Rizlenee/Droduino/README.md

Ce projet est réalisé dans le cadre de la formation de prépa intégrée de Polytech'Nice Sophia. 

<h1>Projet Arduino PeiP2</h1>

<h2>DRODUINO</h2>

Les membres de la (dream)team pour ce projet sont:
<ul>
<li>EL BOUCHIKHI Rizlène</li>
<li>ERRIADI Yasmin</li>
<li>BAUCE Camille</li>
</ul>

<h2>LE PROJET</h2>
Nous souhaitons construire un drone de vitesse, équipée d'un caméra reliée à casque FPV et de plusieurs améliorations ludiques facilitant le pilotage à savoir une de batterie qui s'allume quand la batterie est faible, des leds de position dont la télcommande peut changer les couleurs, des phares dont l'intensité peut être modifiée par la télécommande également et un buzzer déclenchable à distance par la télécommande en cas de perte du drone.

<h2>DOCUMENTATION :</h2>
<ul>
<li>manuel de la SPRacingF3 (controlleur de vol) : http://seriouslypro.com/files/SPRacingF3-Manual-latest.pdf</li>
<li>identification pin ESC : https://github.com/sim-/tgy/wiki/Identifying-ESC-pin-configuration</li>
 </ul>

<h2>COMPOSANTS PRINCIPAUX :</h2>

  - 1x Chassis
  - 4x Moteurs
  - 4x Controleurs de vitesse électronique (ESC)
  - 4x Helices
  - 1x Batterie
  - 1x Controleur de vol (carte arduino ou non)
  - 1x Lunettes FPV (on a les lunettes fatshark fpv 1100 avec sa camera)
  - 1x Radio Emetteur/Recepteur (aka manette et recepteur de la manette pour la carte)

<h2>PROJET TERMINE</h2>

<p>
 
 
 </p>
