Rizlenee/Droduino/doc/Yasmin ERRIADI.md

<h1>CARNET DE BORD DE YASMIN</h1> 

* <h2>Séance du 22 Décembre 2017:</h2>

Nous avons réflechi à un sujet pour le projet. Après avoir longuement discuté avec les deux autres membres du groupe, nous nous sommes
décidé sur la coonception d'un drône. Puis après concertation avec Mr Masson, nous avons finit par choisir de faire un drône de vitesse
avec des lunettes connectées (drône FPV). J'ai alors entamé, les recherches sur le fonctionnement d'un drône FPV.

* <h2>Séance du 12 Janvier 2018:</h2>

Nous avons continué les recherches sur le fonctionnement d'un drône, j'ai trouvé ce site très intéressant:
http://www.geekmag.fr/quadricoptere-fonctionnement-configuration-et-pilotage-rc/. 
J'ai regardé des vidéos sur des courses avec des FPV, dont celle là https://www.youtube.com/watch?v=hjFoPGniwdk où l'on a la vue
dans sur les lunettes reliées à la camera sur le drone.

* <h2>Séance du 18 Janvier 2018:</h2>

J'ai fait des recherches sur les pièces nécessaires pour l'assemblage du drone (chassis, esc et moteur), afin de preparer notre 
première commande. J'ai cherché sur le site: https://www.drone-fpv-racer.com/, nous avons réparé certaines pièces mais nous hésitions toujours. 
J'ai également commencé à préparer la présentation orale.

* <h2>Séance du 23 Janvier 2018:</h2>

Nous avons fait notre présentation du projet et j'ai ecouté les présentations des autres. Nous avons également posé pour le magazine de la 
CASA avec le drone fait par Julien l'an dernier.

* <h2>Séance du 02 Février 2018:</h2>
Nous avons reçu le colis du kit d'assemblage du drone. Nous avons donc commencé l'assemblage du chassis, nous avons vissé les parties inferieures du chassis ensemble et les parties superieures ensemble. 
Nous n'assemblerons les deux parties du chassis qu'une fois que l'on aura ajouté les autres composants.

* <h2>Après-midi du 15 Février 2018:</h2>
Nous avons vissé les moteurs au chassis puis nous avons mis les hélices que nous n'avons pas laissé par manque de praticité.

* <h2>Journée du 21 Février 2018:</h2>
Il nous fallait des entretoises pour séparer la carte de vol et la carte de distribution d'énergie que camille est allée au fablab:

 
 * <h2>Séance du 16 Mars 2018:</h2>
 Nous avons soudé les esc avec les moteurs, d'abord Mr.Ferreronous a montré puis nous sommes allé au Fablab. Puis nous avons soudé des pins à la carte de vol pour y brancher les ecs ou les led plus tard.
 
  
 * <h2>Après-midi du 28 Mars 2018:</h2> 
 Nous sommes allées au Fablab pour souder les esc à la plaque de distribution d'énergie ainsi que rajouter des pins.
 
 * <h2>Séance du 29 Mars 2018:</h2>
 Nous avons soudé la prise pour brancher la batterie à la plaque de distribution. Le prof nous a donné les lunettes FPV et la caméra. Il faut maintenant connecter les esc à la carte de vol et tester les moteurs.
 
 * <h2>Séance du 5 Avril 2018:</h2>
 Nous avons ressoudé les branchements esc-moteurs les moteurs tournés tous dans le même sens et que l'on arrivait pas acceder aux esc. Nous avons fait des recherches sur la radio et la télécommande, puis onous avons commencé les branchements de la radio.
 
 * <h2>Séance du 9 Avril 2018:</h2>
 Lors des tests effectués par Camille un des esc a brulé, on a donc déssoudé cet esc pendant la séance. Nous avons fait notre présentation, à la fin le prof nous a suggéré d'utiliser une arduino pro-micro pour le branchement des led et du buzzer pour ne pas toucher au programme de la carte de vol.

 * <h2>Séance du 2 Mai 2018:</h2>
   Mr Masson nous a donné les leds strips et nous avons essayé de comprendre leur fonctionnement.

 * <h2>Séance du 9 Mai 2018:</h2>
 Nous avons testé  des codes avec les leds strips connecté à la pro-micro. La carte chauffe nous avons donc essyé avec des leds.

 * <h2>Après-midi du 24 Mai 2018:</h2>
 J'ai cherché comment fonctionne le buzzer que nous avons reçu sachant que ce n'était pas tout à fait celui que nous avions commandé.
 J'ai utilsé la fonction tone() qui génere une onde à une fréquence choisie durant une periode choisie.
 
  * <h2>Après-midi du 28 Mai 2018:</h2>
  Nous sommes allées au Fablab pour crée des fils avec plusieurs sorties à partir de fils simples pour les connecter à la carte de vol car certains pins alimentent plusieurs éléments.
  
   * <h2>Après-midi du 29 Mai 2018:</h2>
   Nous avons continué le code des leds, pour chaque position du boutons switch on a choisis un éclairage( clignotant rouge, arc-en-ciel...) fournit par les leds. Mais lorsque l'on a branché le tout sans relier la carte à l'ordinateur, les valeurs reçues par la radio sont anormales.
   
   * <h2>Après-midi du 30 Mai 2018:</h2>
   Nous avons modifié le code des leds strips afin de régler le problème des valeurs instables qui était du au mauvais usage de la fonction show().
   A présent ce problème est réglé et chaque position du switch affiche la couleur souhaitée.
  
   * <h2>Après-midi du 31 Mai 2018:</h2>
   Nous avons finalisé l'assemblage du drone et collé les leds strips tout autour du drone. Nous avons fait voler le drone qui est stable au demarrage mais lors de l'atterissage un peu trop brutale une pale s'est cassée.
