Rizlenee/Droduino/DRODUINO - PART 3.pdf

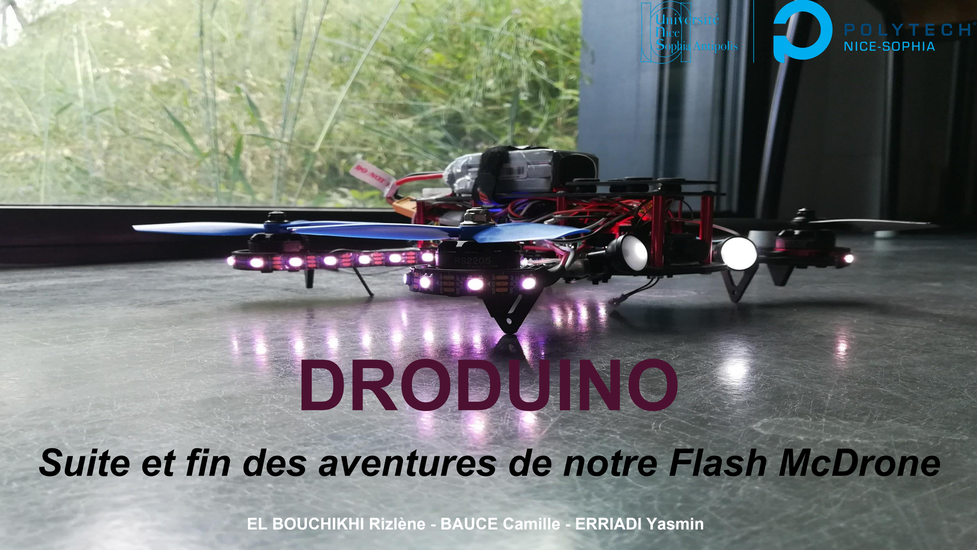
[picture p9: page 1]

# DRODUINO

## Suite et fin des aventures de notre Flash McDrone

EL BOUCHIKHI Rizlène - BAUCE Camille - ERRIADI Yasmin

## SOMMAIRE

❖ INTRODUCTION
❖ MATÉRIEL UTILISÉ
❖ FONCTIONNEMENT
❖ PROBLÈMES RENCONTRÉS ET SOLUTIONS TROUVÉES ❖ DIAGRAMMES DE GANTT
❖ CONCLUSION

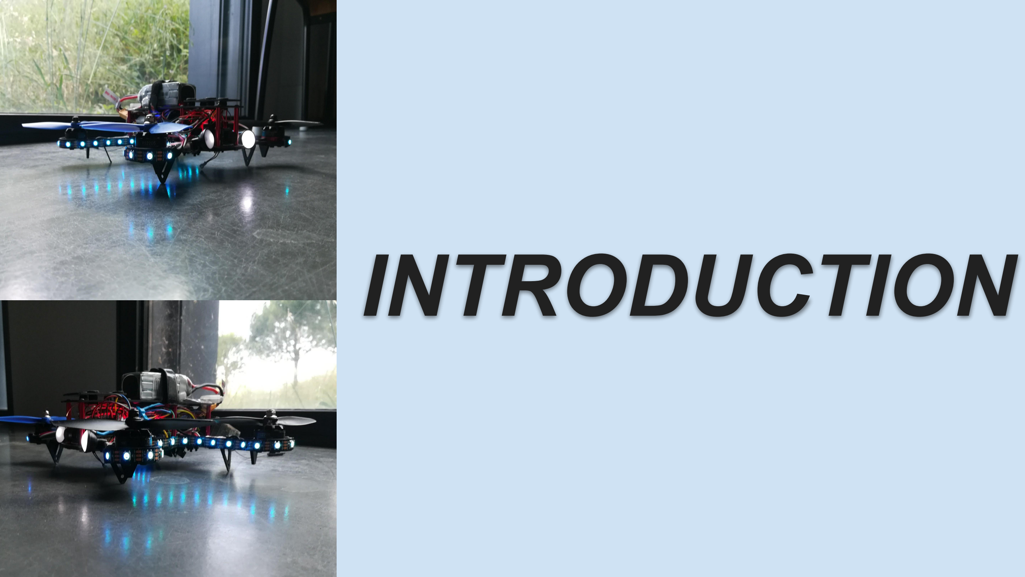
[picture p10: page 3]

# INTRODUCTION

❖ DESCRIPTION DU PROJET :

Nous avions pour projet de réaliser un drone (Flash McDrone) munis d’une caméra FPV avec et des composants supplémentaires :

- leds de positions dont les couleurs sont modifiées à distance
- buzzer déclenchable à distance
- phares dont l’intensité est gérées à distance
- une led batterie indicatrice du niveau de batterie
❖ OBJECTIFS | :
- Réalisation du drone
- Ajout des éléments supplémentaires

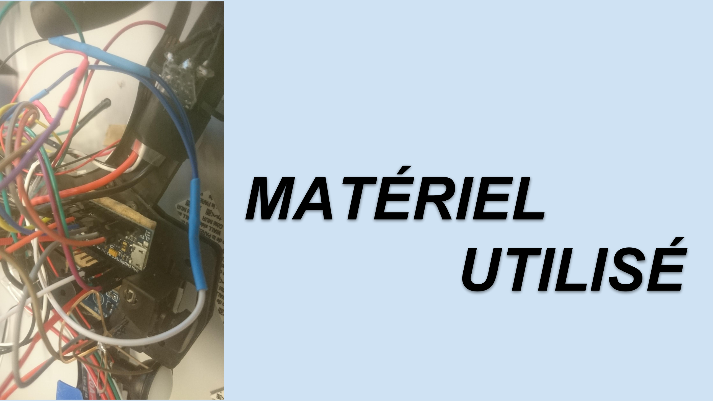
[picture p11: page 5]

# MATÉRIEL UTILISÉ

❖ MATÉRIEL PRINCIPALE :

- Kit drone : châssis , esc , moteurs , hélices…
- Récepteur et radio commande PWM
- Caméra et son casque FPV

❖ MATÉRIEL POUR LES AJOUTS :

- Buzzer 5V
- Phares 5V
- Led strip 60 leds
- Arduino pro micro

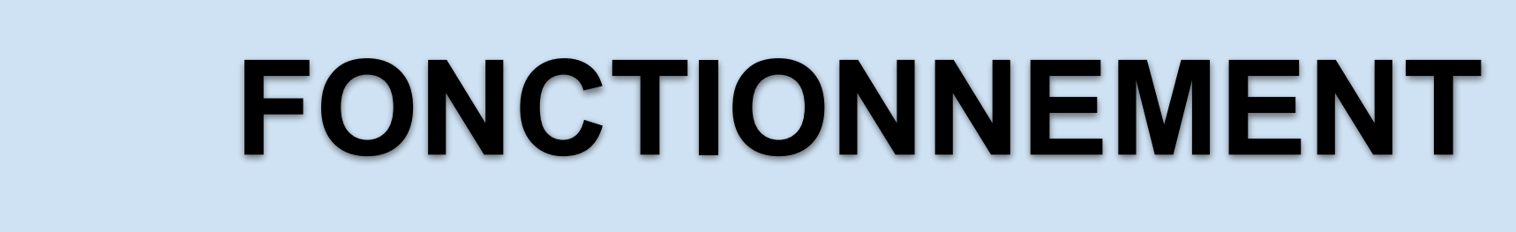
[picture p12: figure]
FONCTIONNEMENT
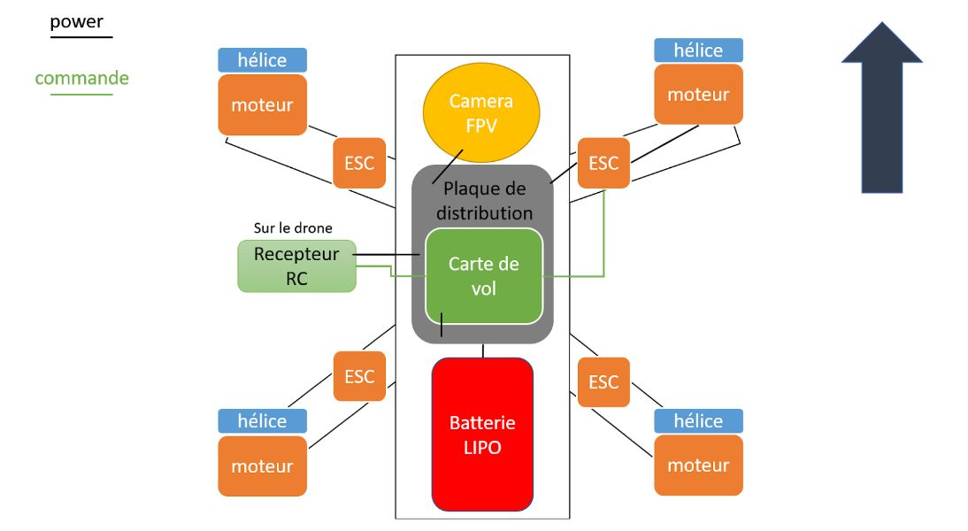
[picture p13: page 8]
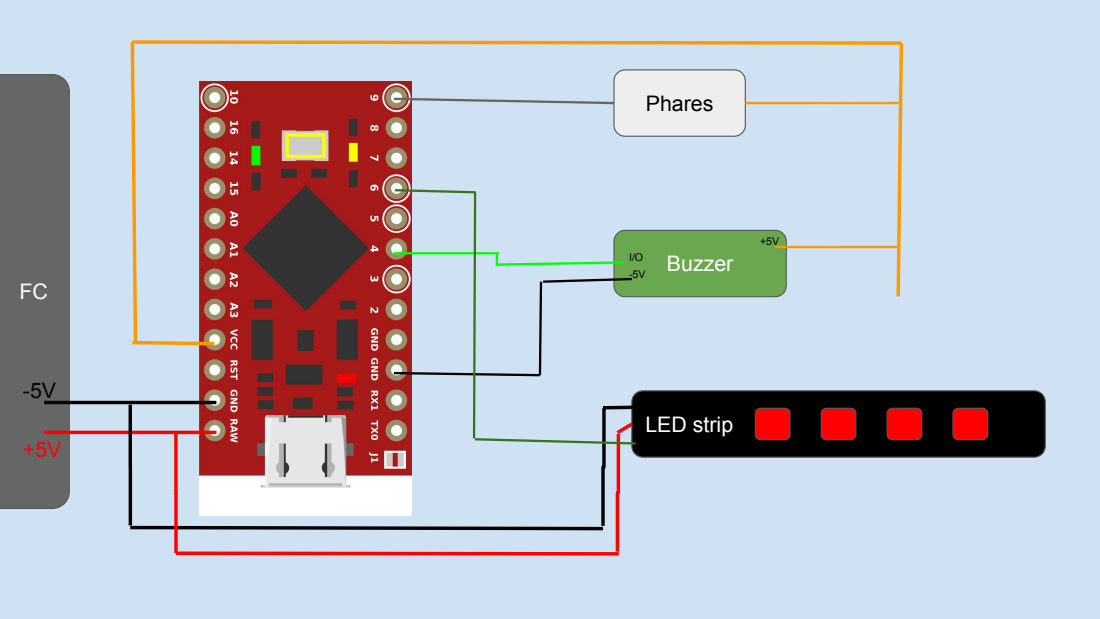
[picture p14: page 9]
Buzzer; Phares; LED strip

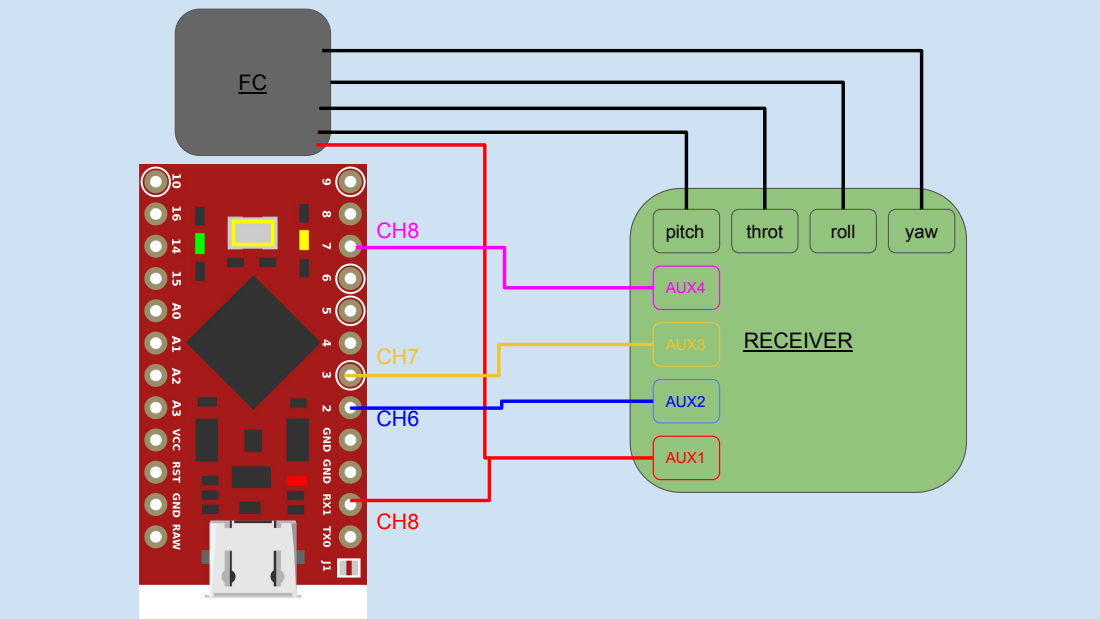
[picture p15: page 10]
RECEIVER; pitch; throt; roll; yaw; AUX1; AUX2; AUX3; AUX4

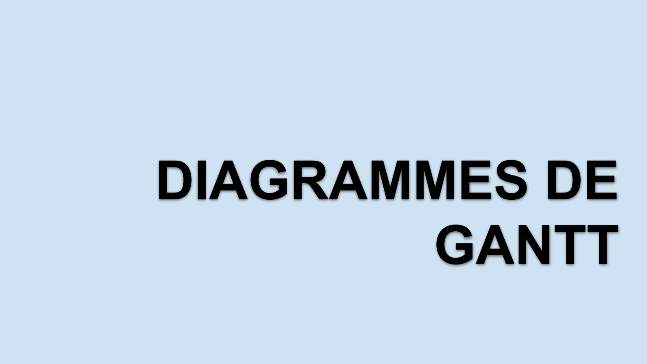
[picture p16: page 11]

# DIAGRAMMES DE GANTT

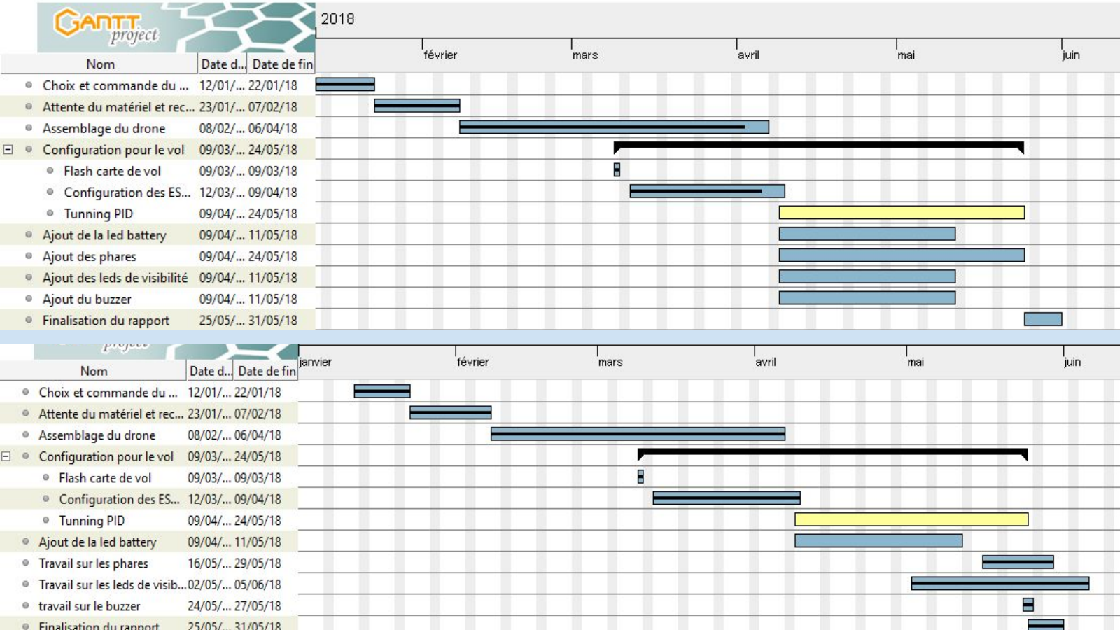
[picture p17: page 12]

# PROBLÈMES

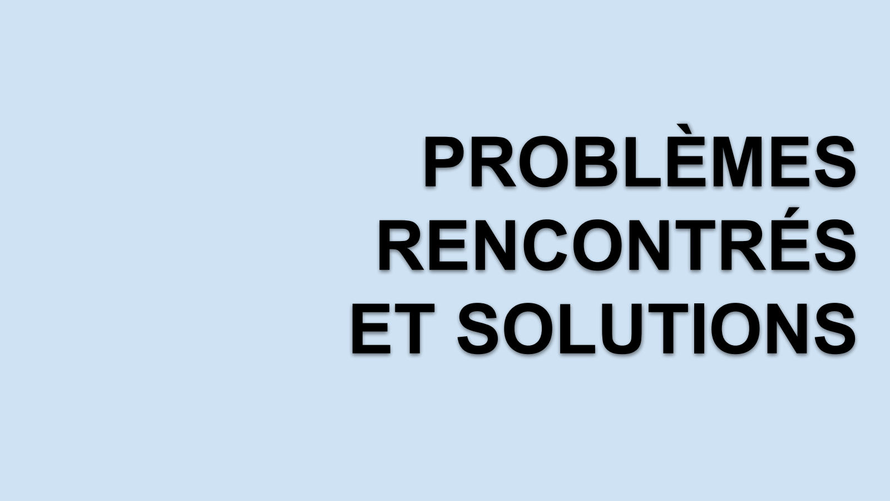
[picture p18: page 13]

# RENCONTRÉS ET SOLUTIONS

PROBLEMES
D’ELECTRONIQUE

Configuration des ESC
→ Inversement
des soudures

Combustion d’un ESC
→ Remplacement
de l’ESC

Pins partagées
→ Fabrication de
nouveaux fils

PROBLÈMES
D’INFORMATIQUE

CleanFlight

delay() dans le code
des leds
→ Nouveau code
avec des millis()

show() de Adafruit
faussant l’acquisition
→ Arrêt acquisition
pendant la fonction
puis redémarrage

PROBLÈMES
D’ERGONOMIE

FC et PDE

Arduino et buzzer

Les phares

La quantités de fils

La caméra FPV et sa
batterie

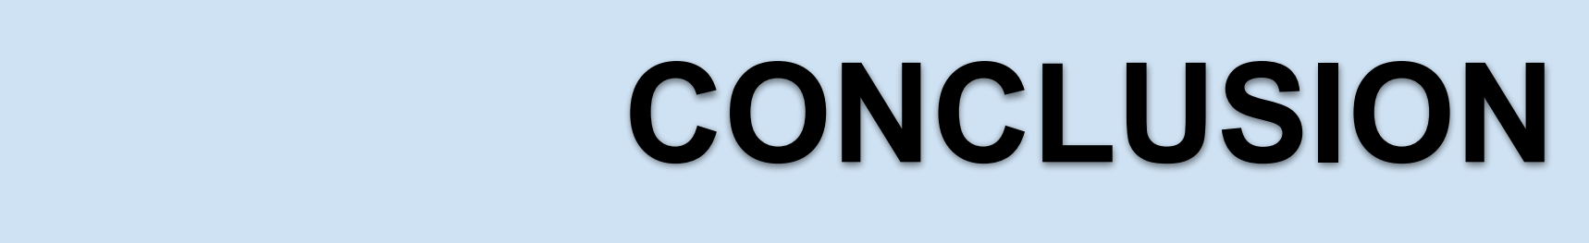
[picture p19: figure]
CONCLUSION

❖ SYNTHÈSE
- Un de nos projets les plus intéressant
- Une démarche de recherche et de réflexion sur des problèmes concrets
- Réalisation de presque tous nos objectifs

❖ PERSPECTIVES
- Ajout de la led batterie manquante
- Configuration des PIDs pour l’optimisation de vol
- Changement des hélices

# C’était

# DRODUINO

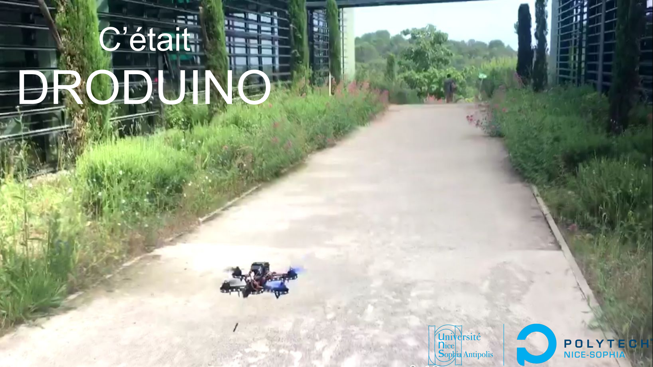
[picture p20: page 17]
